13/muhradio_pcb/transmitter/cc1101/fab/drc_report.txt

** Drc report for promini_cc1101.kicad_pcb **
** Created on 2026-09-24T08:30:56 **
** Report includes: Errors, Warnings, Exclusions **

** Found 0 DRC violations **

** Found 0 unconnected pads **

** Found 0 Footprint errors **

** Ignored checks **
    - Footprint has no courtyard defined
    - Track endpoint not centered on via
    - Tuning profile track geometries
    - Footprint doesn't match symbol's footprint filters
    - Footprint component type doesn't match footprint pads

** End of Report **
