13/muhradio_pcb/receiver/cc1101/esp32s3zero/fab/preview_bottom.png

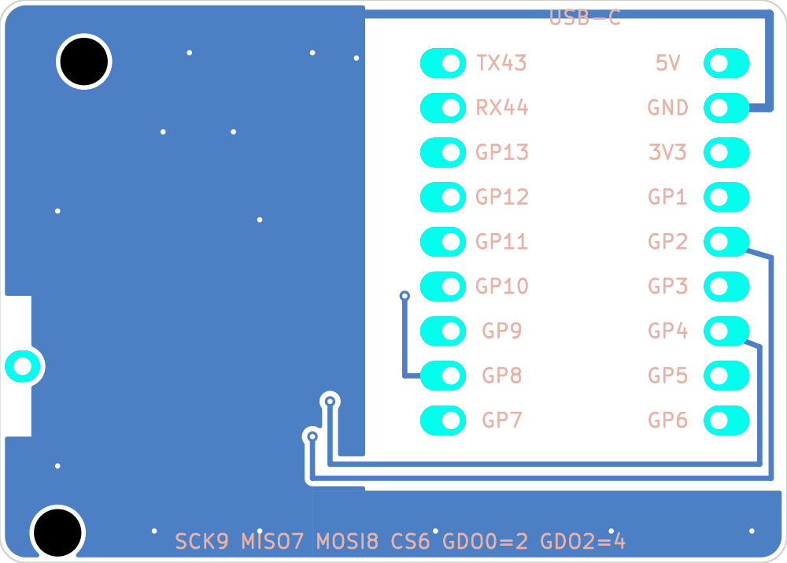
receiver/cc1101/esp32s3zero/fab/preview_bottom.png
