13/muhradio_pcb/receiver/cc1101/esp32s3zero/fab/preview_top.png

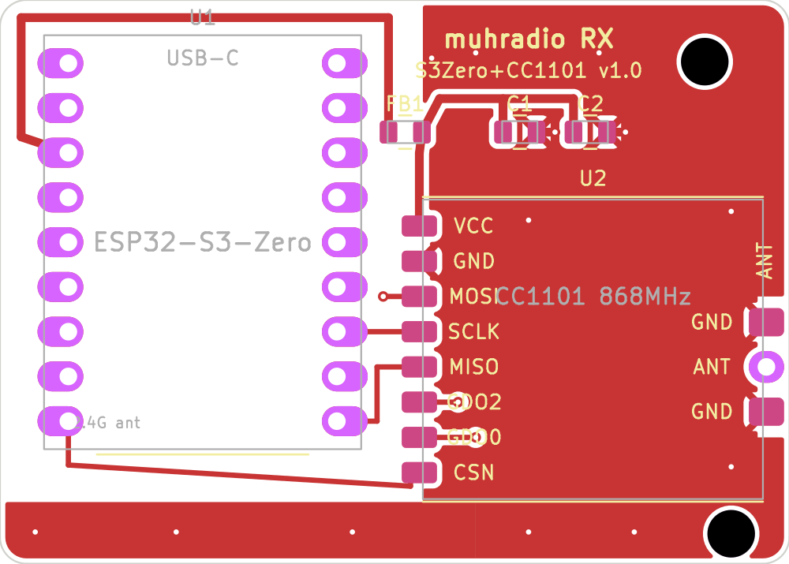
receiver/cc1101/esp32s3zero/fab/preview_top.png
