13/muhradio_pcb/receiver/cc1101/esp32s3zero/fab/render_bottom.png

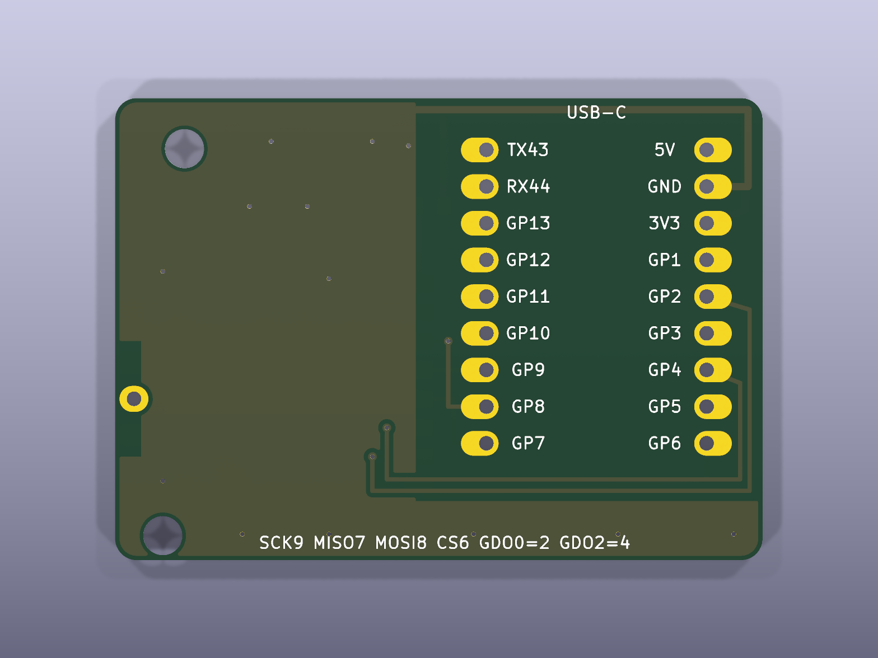
receiver/cc1101/esp32s3zero/fab/render_bottom.png
