13/muhradio_pcb/receiver/cc1101/esp32s3zero/fab/render_top.png

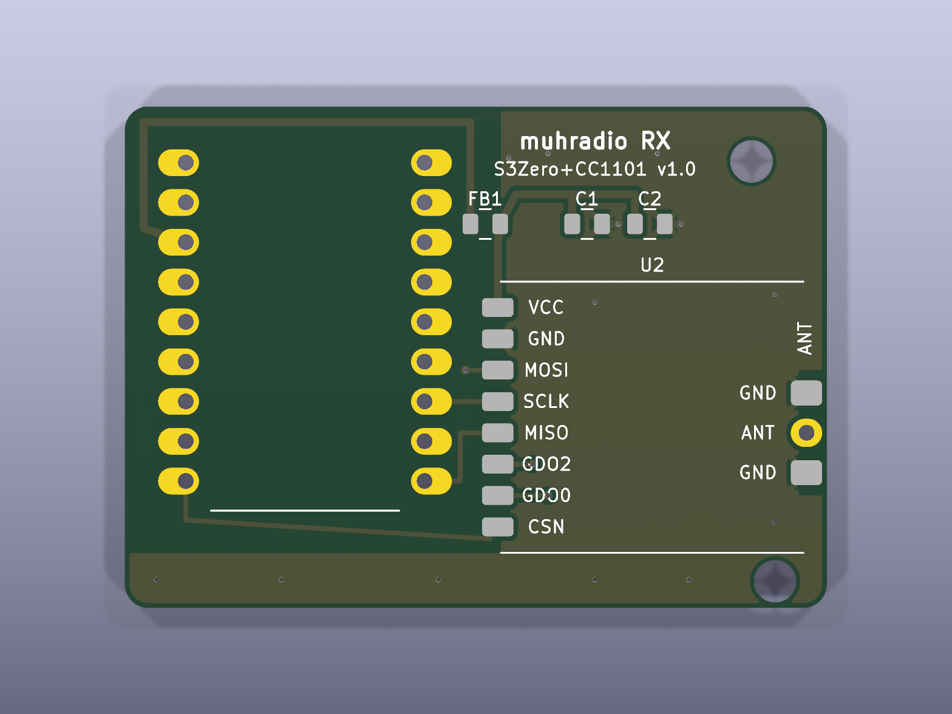
receiver/cc1101/esp32s3zero/fab/render_top.png
