13/muhradio_pcb/receiver/cc1101/esp32s3zero/fab/schematic.png

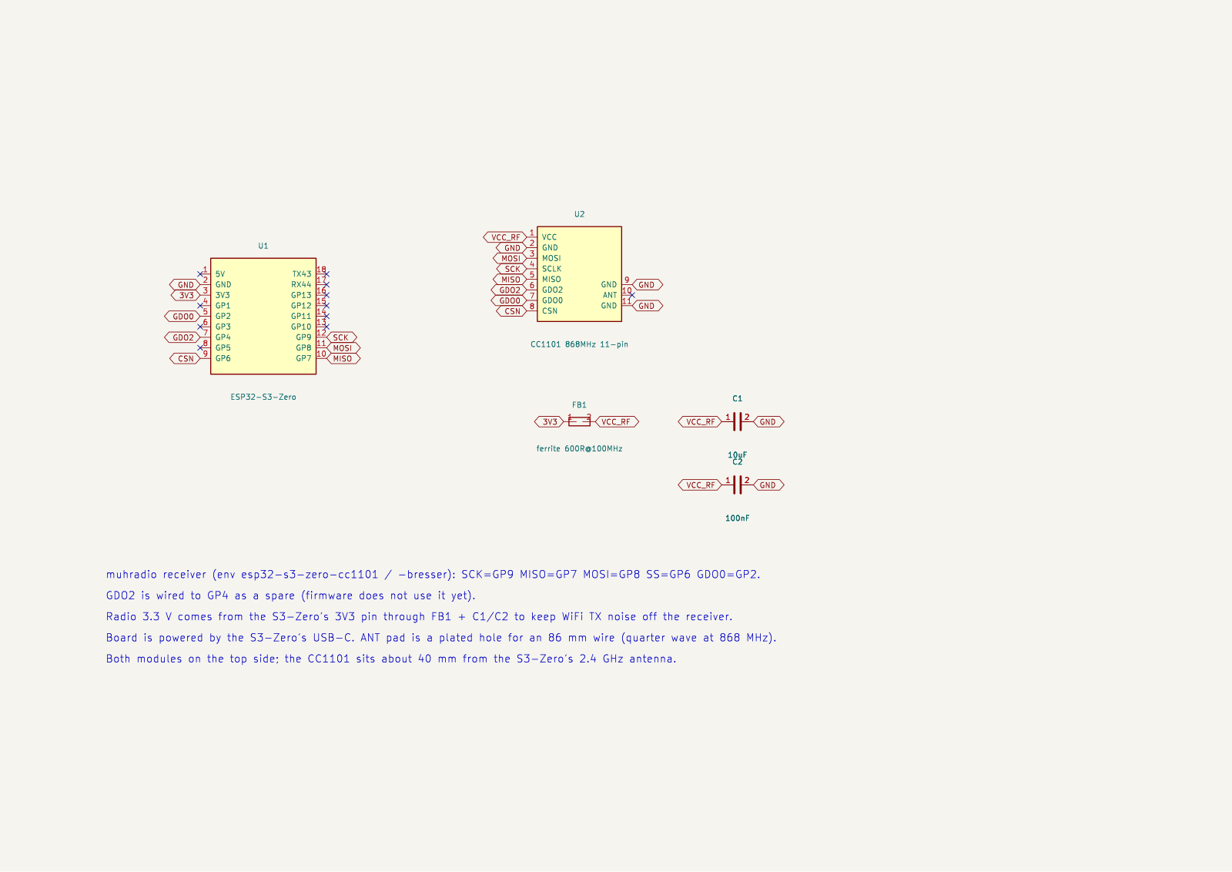
receiver/cc1101/esp32s3zero/fab/schematic.png
