13/muhradio_pcb/transmitter/cc1101/fab/preview_bottom.png

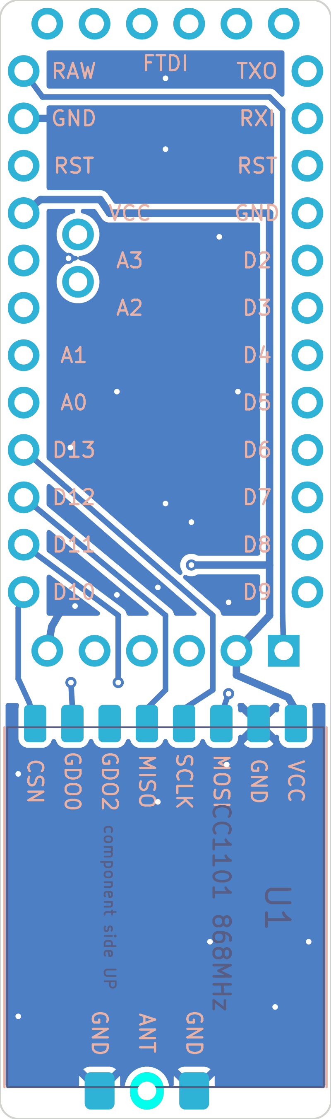
transmitter/cc1101/fab/preview_bottom.png
