13/muhradio_pcb/transmitter/cc1101/fab/preview_top.png

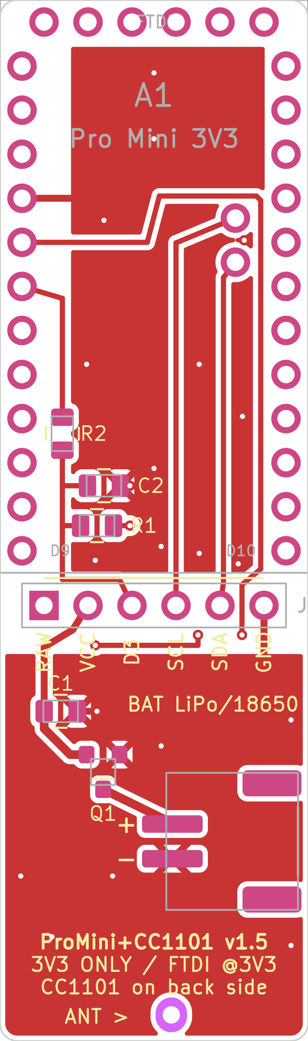
transmitter/cc1101/fab/preview_top.png
