13/muhradio_pcb/transmitter/cc1101/fab/render_bottom.png

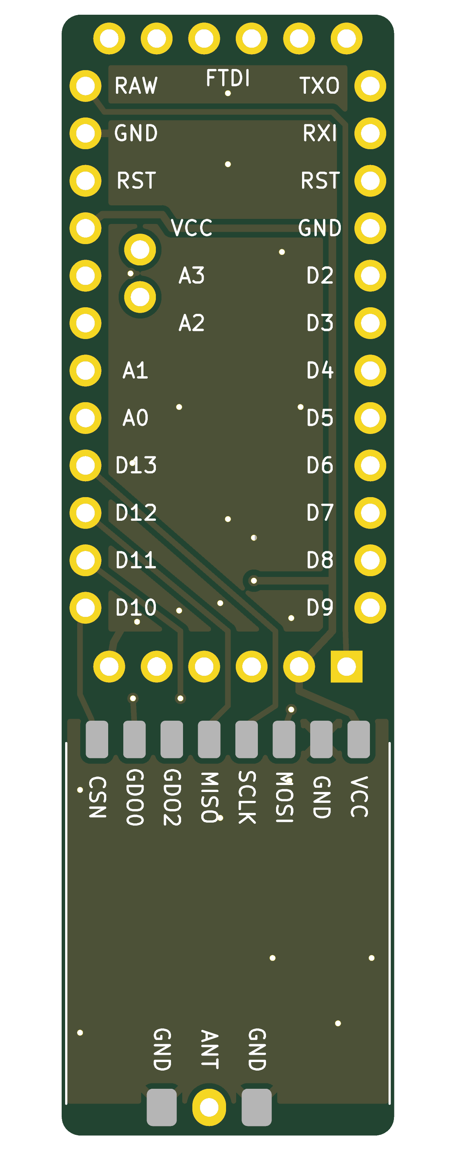
transmitter/cc1101/fab/render_bottom.png
