13/muhradio_pcb/transmitter/cc1101/fab/render_top.png

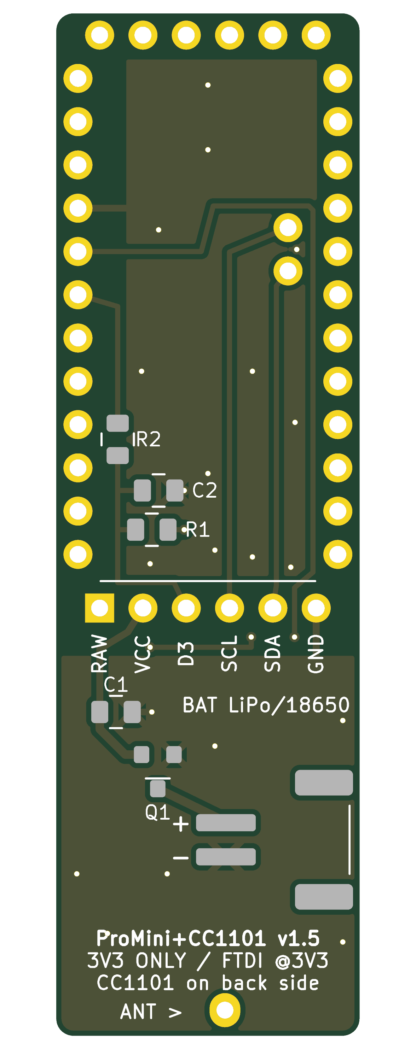
transmitter/cc1101/fab/render_top.png
