13/muhradio_pcb/transmitter/cc1101/fab/schematic.png

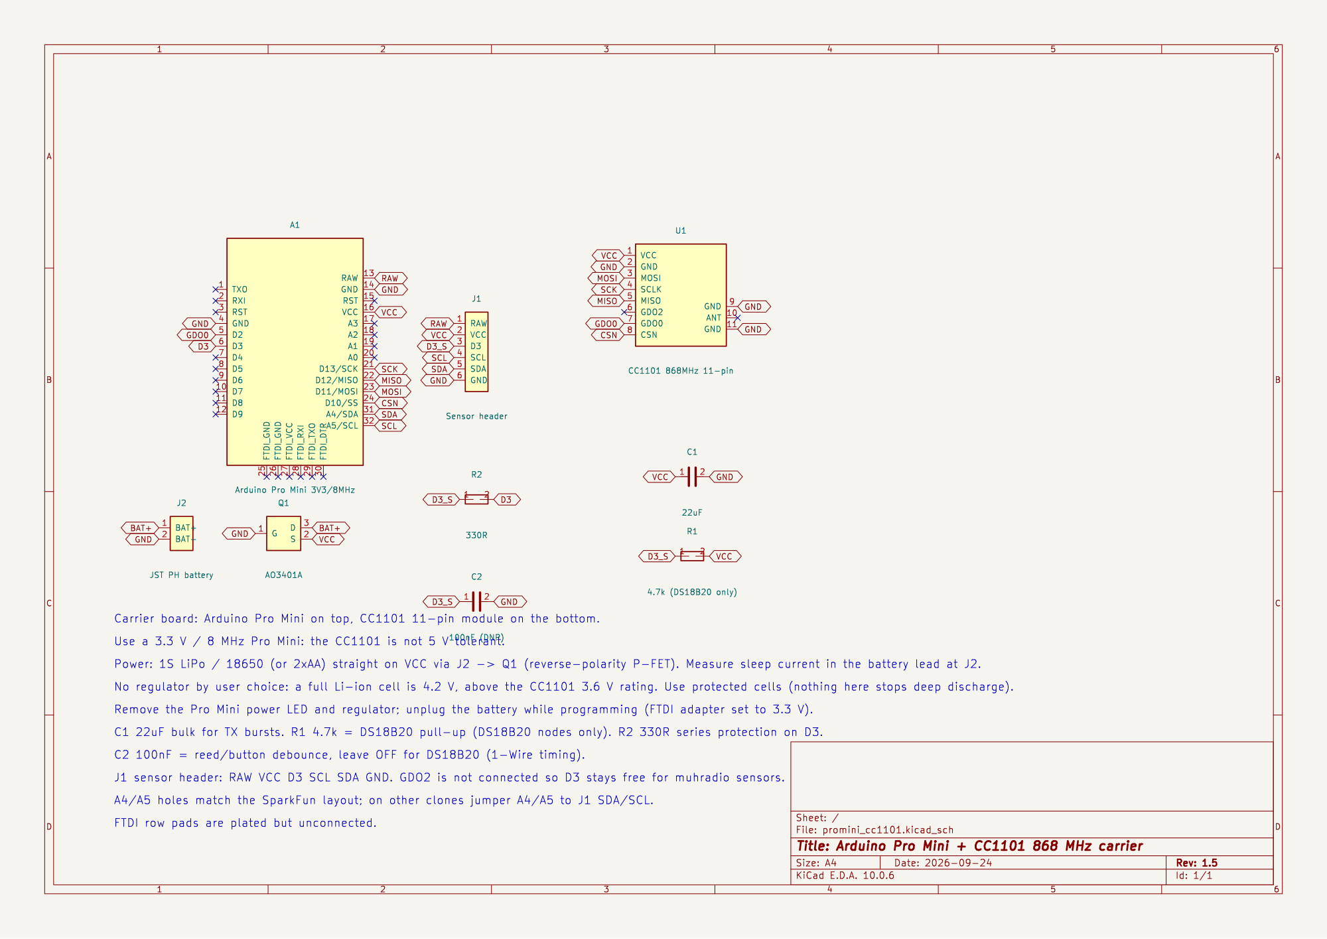
transmitter/cc1101/fab/schematic.png
