13/muhradio_pcb/transmitter/cc1101/fab/v1.4/render_top.png

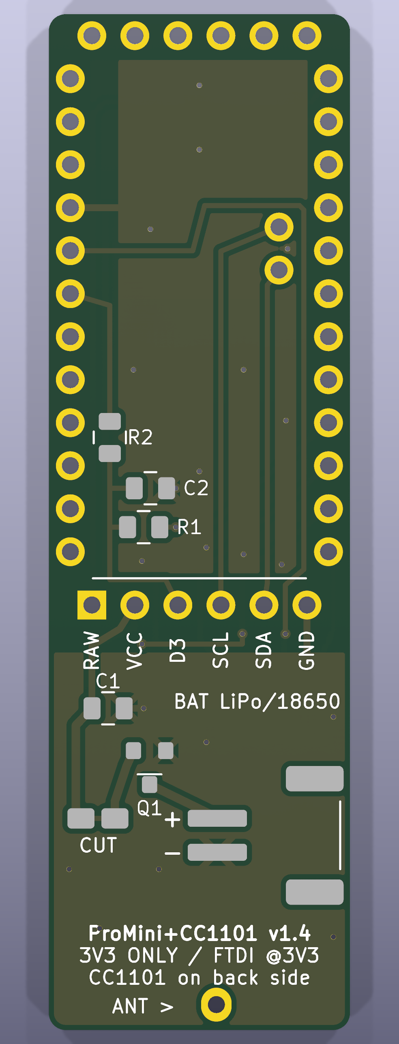
transmitter/cc1101/fab/v1.4/render_top.png
