13/muhradio_pcb/transmitter/lora/fab/preview_bottom.png

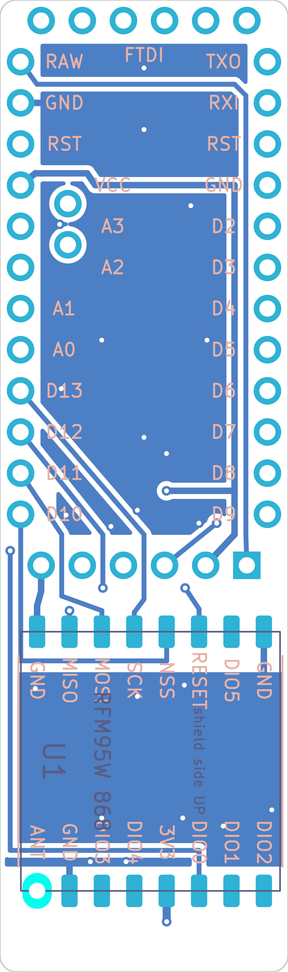
transmitter/lora/fab/preview_bottom.png
