13/muhradio_pcb/transmitter/lora/fab/preview_top.png

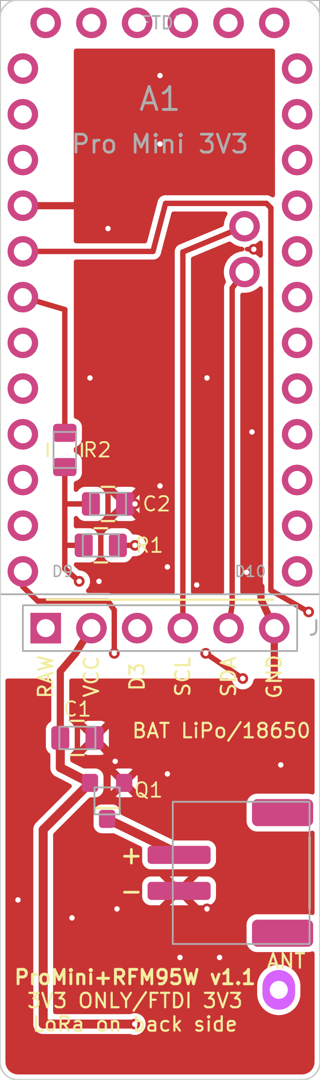
transmitter/lora/fab/preview_top.png
