13/muhradio_pcb/transmitter/lora/fab/render_bottom.png

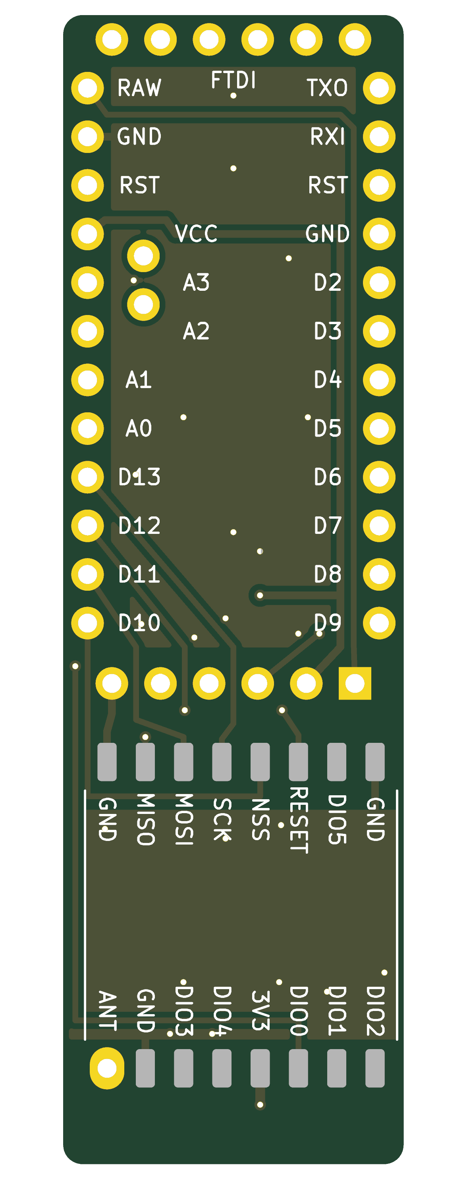
transmitter/lora/fab/render_bottom.png
