13/muhradio_pcb/transmitter/lora/fab/v1.0/render_bottom.png

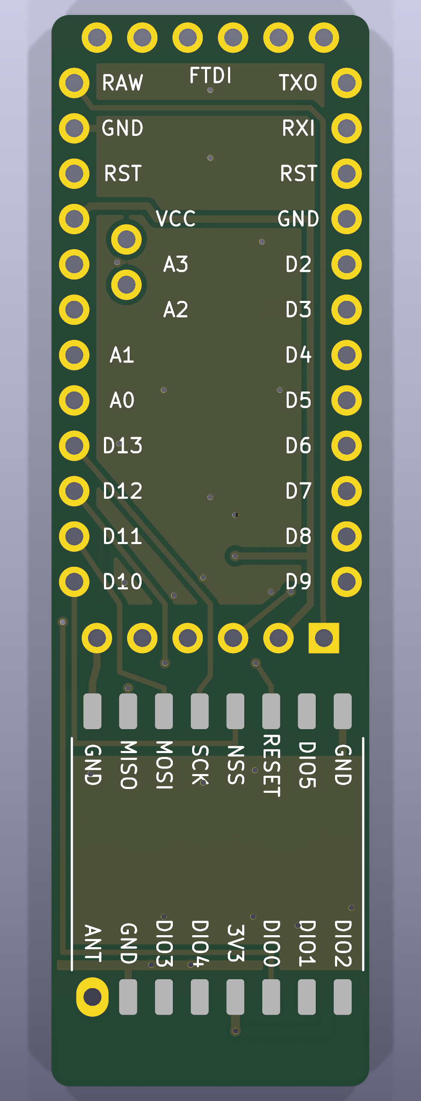
transmitter/lora/fab/v1.0/render_bottom.png
