13/muhradio_pcb/transmitter/enclosure/exports/assembly.step

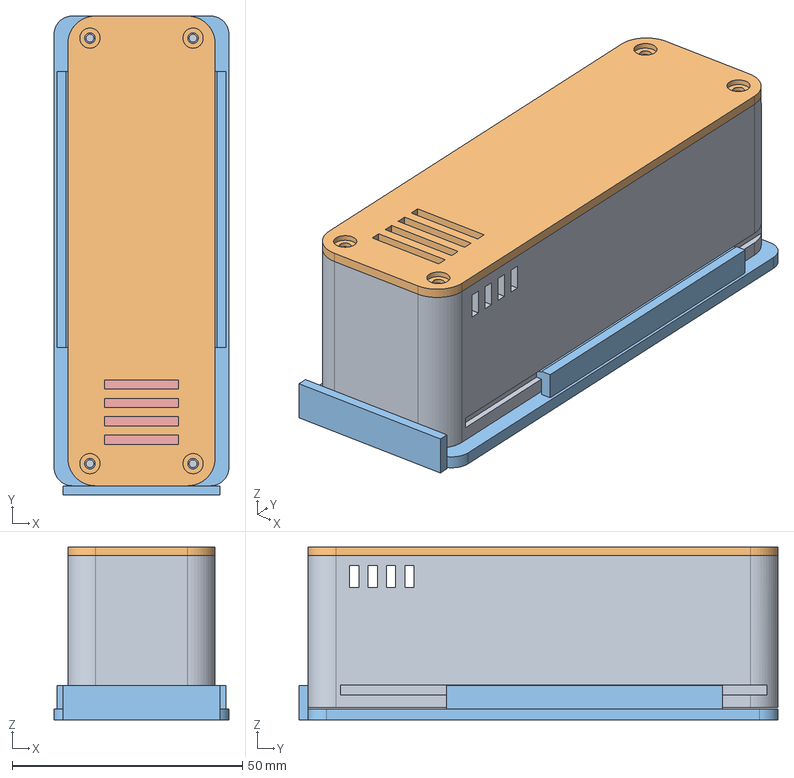
[picture p20: CAD file, 2026-10-30]
transmitter/enclosure/exports/assembly.step
38.0 x 104.0 x 37.5 mm
base
lid
wall_mount
battery_deck
sensor_shelf
