13/muhradio_pcb/transmitter/enclosure/exports/battery_deck.step

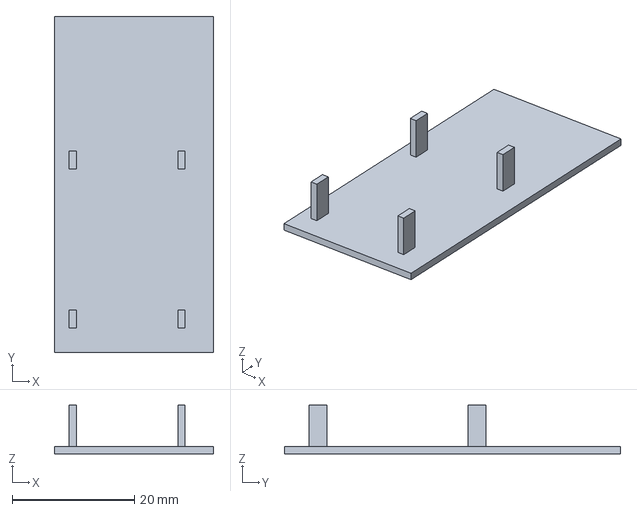
[picture p21: CAD file, 2026-10-30]
transmitter/enclosure/exports/battery_deck.step
26.0 x 55.0 x 8.00 mm
