13/muhradio_pcb/transmitter/enclosure/exports/lid.step

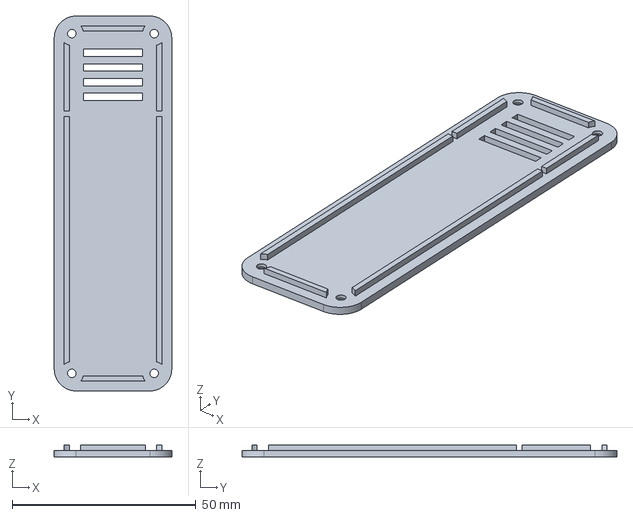
[picture p23: CAD file, 2026-10-30]
transmitter/enclosure/exports/lid.step
32.0 x 102.0 x 3.20 mm
