13/muhradio_pcb/transmitter/enclosure_magnetic/exports/lid.step

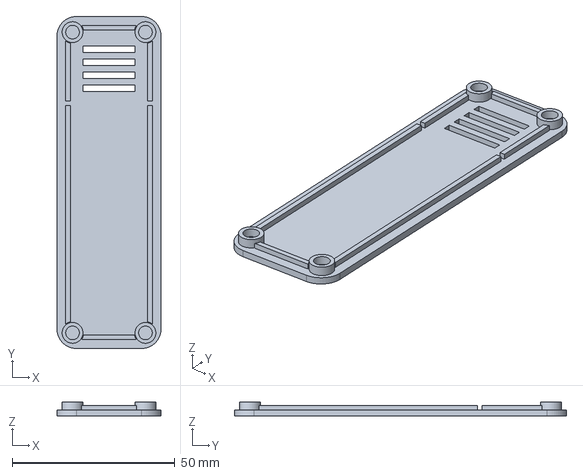
[picture p24: CAD file, 2026-10-30]
transmitter/enclosure_magnetic/exports/lid.step
32.0 x 102.0 x 4.20 mm
