13/muhradio_pcb/transmitter/enclosure_magnetic/exports/wall_mount.step

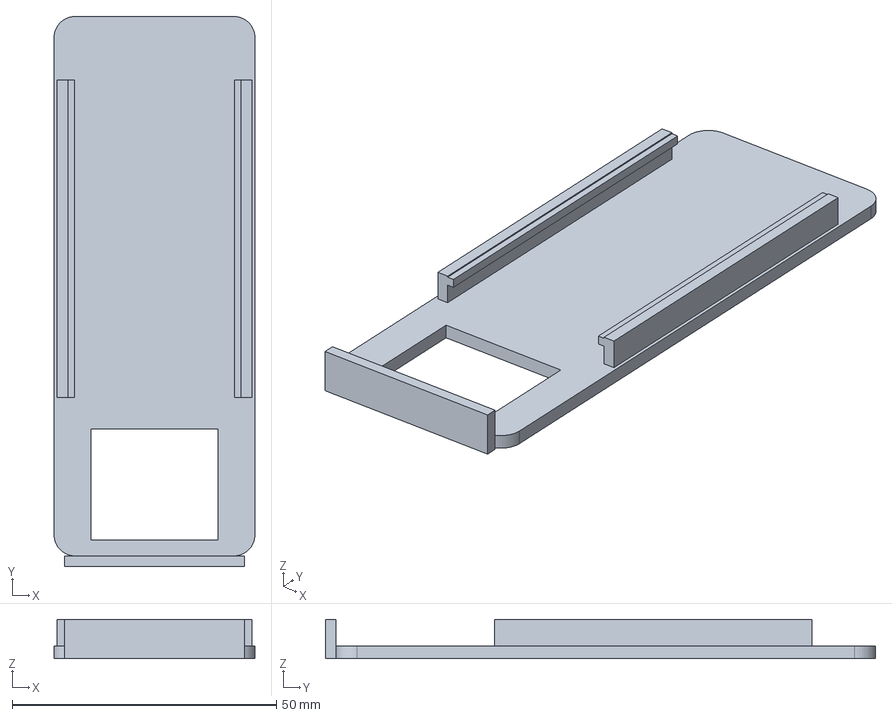
[picture p25: CAD file, 2026-10-30]
transmitter/enclosure_magnetic/exports/wall_mount.step
38.0 x 104.0 x 7.45 mm
