13/muhradio_pcb/transmitter/enclosure/exports/base.step

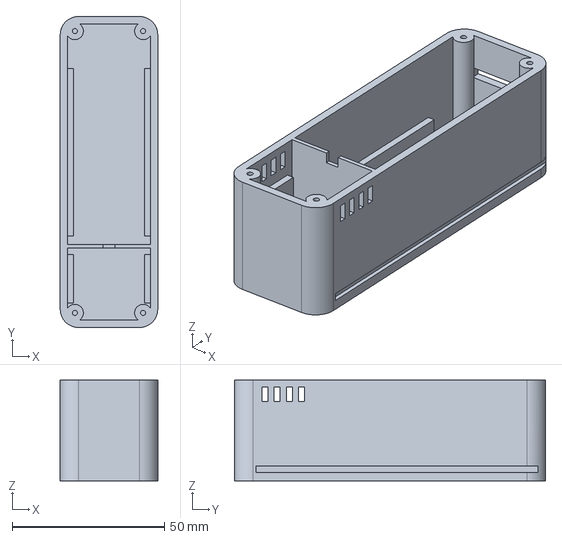
[picture p26: CAD file, 2026-10-30]
transmitter/enclosure/exports/base.step
32.0 x 102.0 x 33.0 mm
