13/muhradio_pcb/transmitter/enclosure_magnetic/exports/base.step

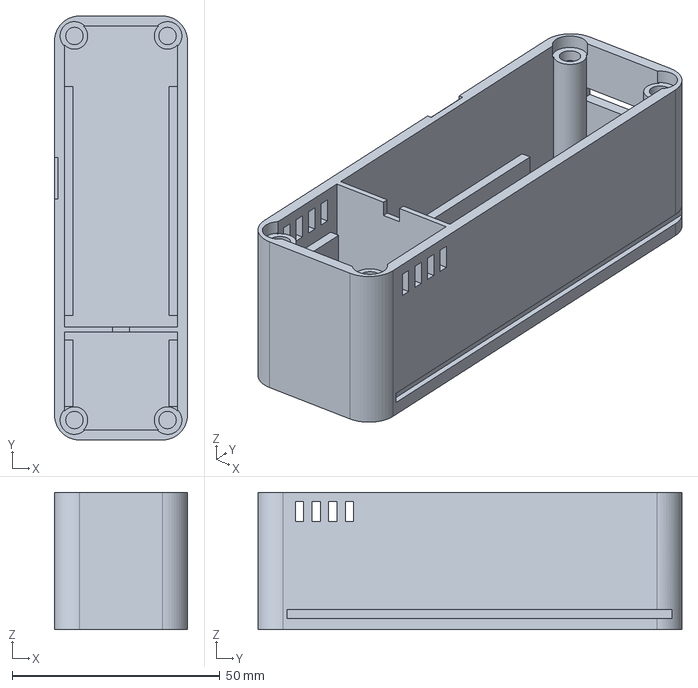
[picture p27: CAD file, 2026-10-30]
transmitter/enclosure_magnetic/exports/base.step
32.0 x 102.0 x 33.0 mm
