13/muhradio_pcb/transmitter/enclosure_screwless/exports/sensor_shelf.step

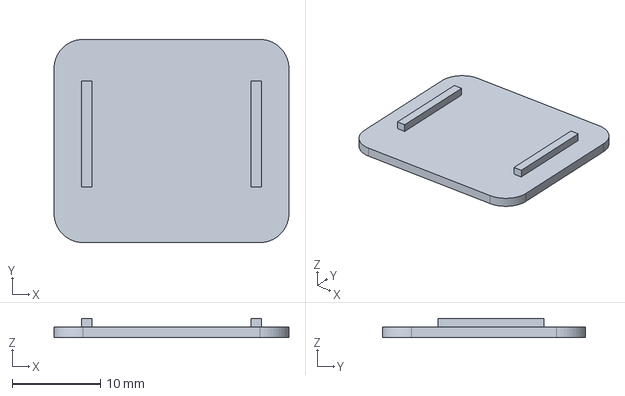
[picture p28: CAD file, 2026-10-30]
transmitter/enclosure_screwless/exports/sensor_shelf.step
26.6 x 23.0 x 2.20 mm
