13/muhradio_pcb/transmitter/enclosure_screwless/exports/lid.step

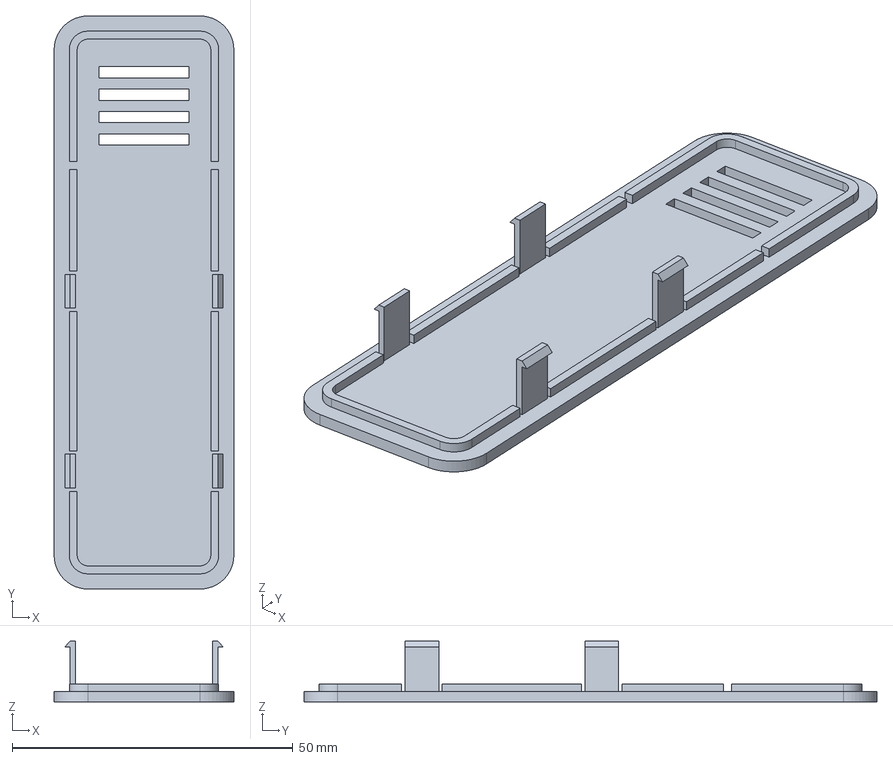
[picture p29: CAD file, 2026-10-30]
transmitter/enclosure_screwless/exports/lid.step
32.0 x 102.0 x 10.8 mm
