13/muhradio_pcb/(list of files, cad)

Other CAD files:
transmitter/enclosure_magnetic/exports/assembly.step
transmitter/enclosure/exports/sensor_shelf.step
transmitter/enclosure_magnetic/exports/battery_deck.step
transmitter/enclosure/exports/wall_mount.step
transmitter/enclosure_screwless/exports/assembly.step
transmitter/enclosure_screwless/exports/base.step
transmitter/enclosure_screwless/exports/battery_deck.step
transmitter/enclosure_screwless/exports/wall_mount.step
transmitter/enclosure/exports/base.stl
transmitter/enclosure/exports/battery_deck.stl
transmitter/enclosure/exports/lid.stl
transmitter/enclosure/exports/sensor_shelf.stl
transmitter/enclosure/exports/wall_mount.stl
transmitter/enclosure_magnetic/exports/base.stl
transmitter/enclosure_magnetic/exports/battery_deck.stl
transmitter/enclosure_magnetic/exports/lid.stl
transmitter/enclosure_magnetic/exports/sensor_shelf.stl
transmitter/enclosure_magnetic/exports/wall_mount.stl
transmitter/enclosure_screwless/exports/base.stl
transmitter/enclosure_screwless/exports/battery_deck.stl
transmitter/enclosure_screwless/exports/lid.stl
transmitter/enclosure_screwless/exports/sensor_shelf.stl
transmitter/enclosure_screwless/exports/wall_mount.stl
