13/muhradio_pcb/transmitter/cc1101/fab/schematic.pdf

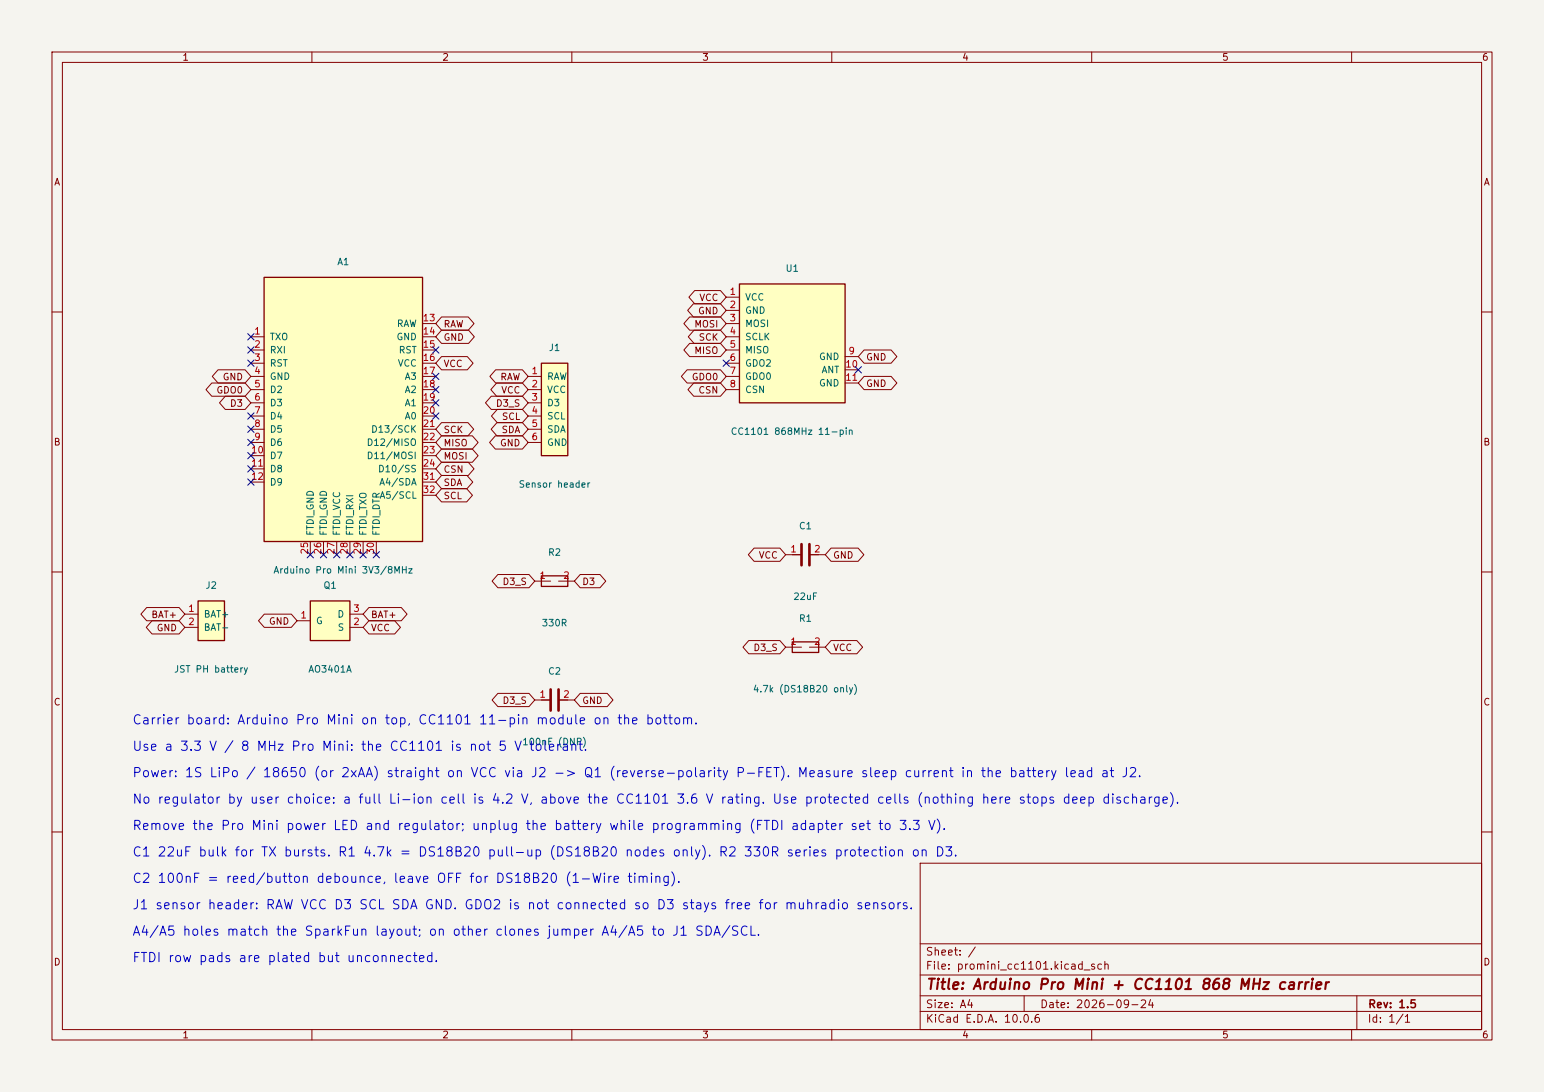
[picture p30: page 1]

GND BAT+
GND
VCC Use a 3.3 V / 8 MHz Pro Mini: the CC1101 is not 5 V tolerant.

Carrier board: Arduino Pro Mini on top, CC1101 11-pin module on the bottom.

Power: 1S LiPo / 18650 (or 2xAA) straight on VCC via J2 -> Q1 (reverse-polarity P-FET). Measure sleep current in the battery lead at J2.

No regulator by user choice: a full Li-ion cell is 4.2 V, above the CC1101 3.6 V rating. Use protected cells (nothing here stops deep discharge).

Remove the Pro Mini power LED and regulator; unplug the battery while programming (FTDI adapter set to 3.3 V).

C1 22uF bulk for TX bursts. R1 4.7k = DS18B20 pull-up (DS18B20 nodes only). R2 330R series protection on D3.

C2 100nF = reed/button debounce, leave OFF for DS18B20 (1-Wire timing).

J1 sensor header: RAW VCC D3 SCL SDA GND. GDO2 is not connected so D3 stays free for muhradio sensors. A4/A5 holes match the SparkFun layout; on other clones jumper A4/A5 to J1 SDA/SCL.

FTDI row pads are plated but unconnected.

Sheet: /
File: promini_cc1101.kicad_sch
Title: Arduino Pro Mini + CC1101 868 MHz carrier

Size: A4 | Rev: 1.5
KiCad E.D.A. 10.0.6 | Id: 1/1
