13/muhradio_pcb/transmitter/lora/fab/schematic.pdf

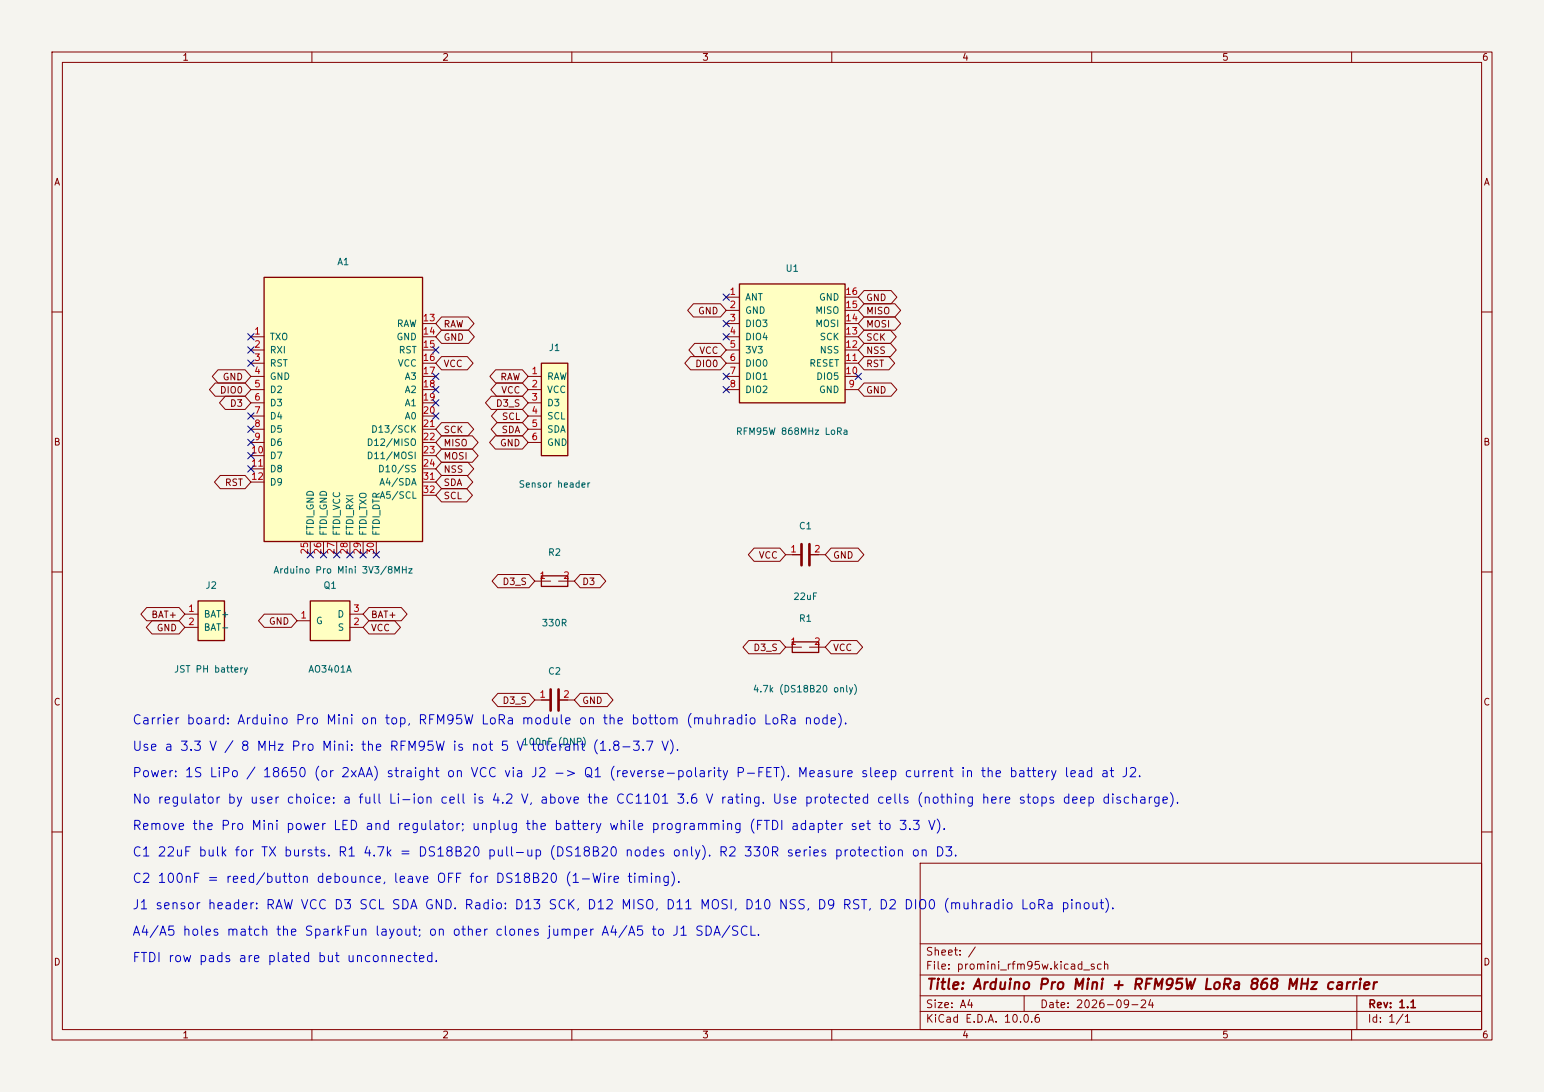
[picture p31: page 1]

VCC J1 sensor header: RAW VCC D3 SCL SDA GND. Radio: D13 SCK, D12 MISO, D11 MOSI, D10 NSS, D9 RST, D2 DIO0 (muhradio LoRa pinout).

Carrier board: Arduino Pro Mini on top, RFM95W LoRa module on the bottom (muhradio LoRa node).

Use a 3.3 V / 8 MHz Pro Mini: the RFM95W is not 5 V tolerant (1.8-3.7 V).

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

C2 100nF = reed/button debounce, leave OFF for DS18B20 (1-Wire timing).

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

FTDI row pads are plated but unconnected.

Sheet: /
File: promini_rfm95w.kicad_sch
Title: Arduino Pro Mini + RFM95W LoRa 868 MHz carrier

Size: A4 | Rev: 1.1
KiCad E.D.A. 10.0.6 | Id: 1/1
