13/muhradio_pcb/receiver/cc1101/esp32s3zero/fab/schematic.pdf

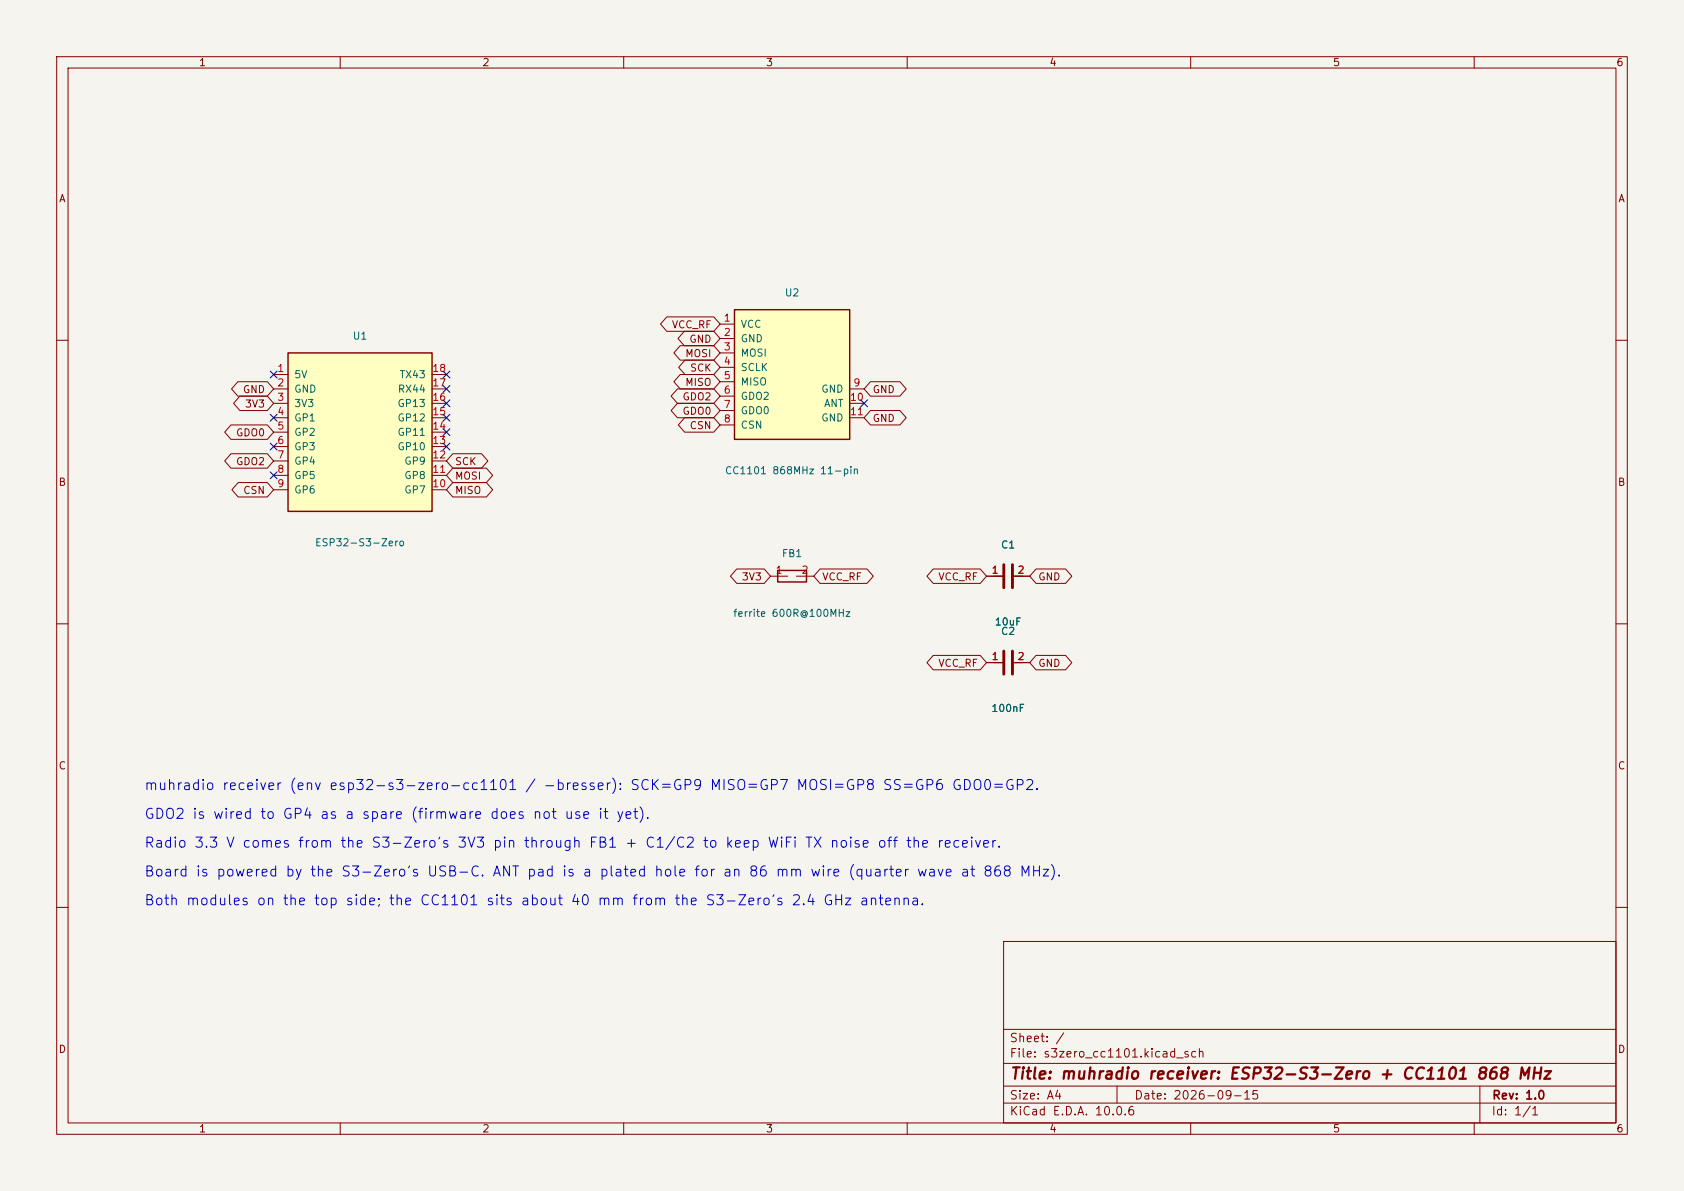
[picture p32: page 1]

muhradio receiver (env esp32-s3-zero-cc1101 / -bresser): SCK=GP9 MISO=GP7 MOSI=GP8 SS=GP6 GDO0=GP2. C2

GDO2 is wired to GP4 as a spare (firmware does not use it yet).

Radio 3.3 V comes from the S3-Zero's 3V3 pin through FB1 + C1/C2 to keep WiFi TX noise off the receiver.
Board is powered by the S3-Zero's USB-C. ANT pad is a plated hole for an 86 mm wire (quarter wave at 868 MHz).

Sheet: /
File: s3zero_cc1101.kicad_sch
Title: muhradio receiver: ESP32-S3-Zero + CC1101 868 MHz

Size: A4 | Rev: 1.0
KiCad E.D.A. 10.0.6 | Id: 1/1
