13/muhradio_pcb/transmitter/cc1101/fab/v1.4/schematic.pdf

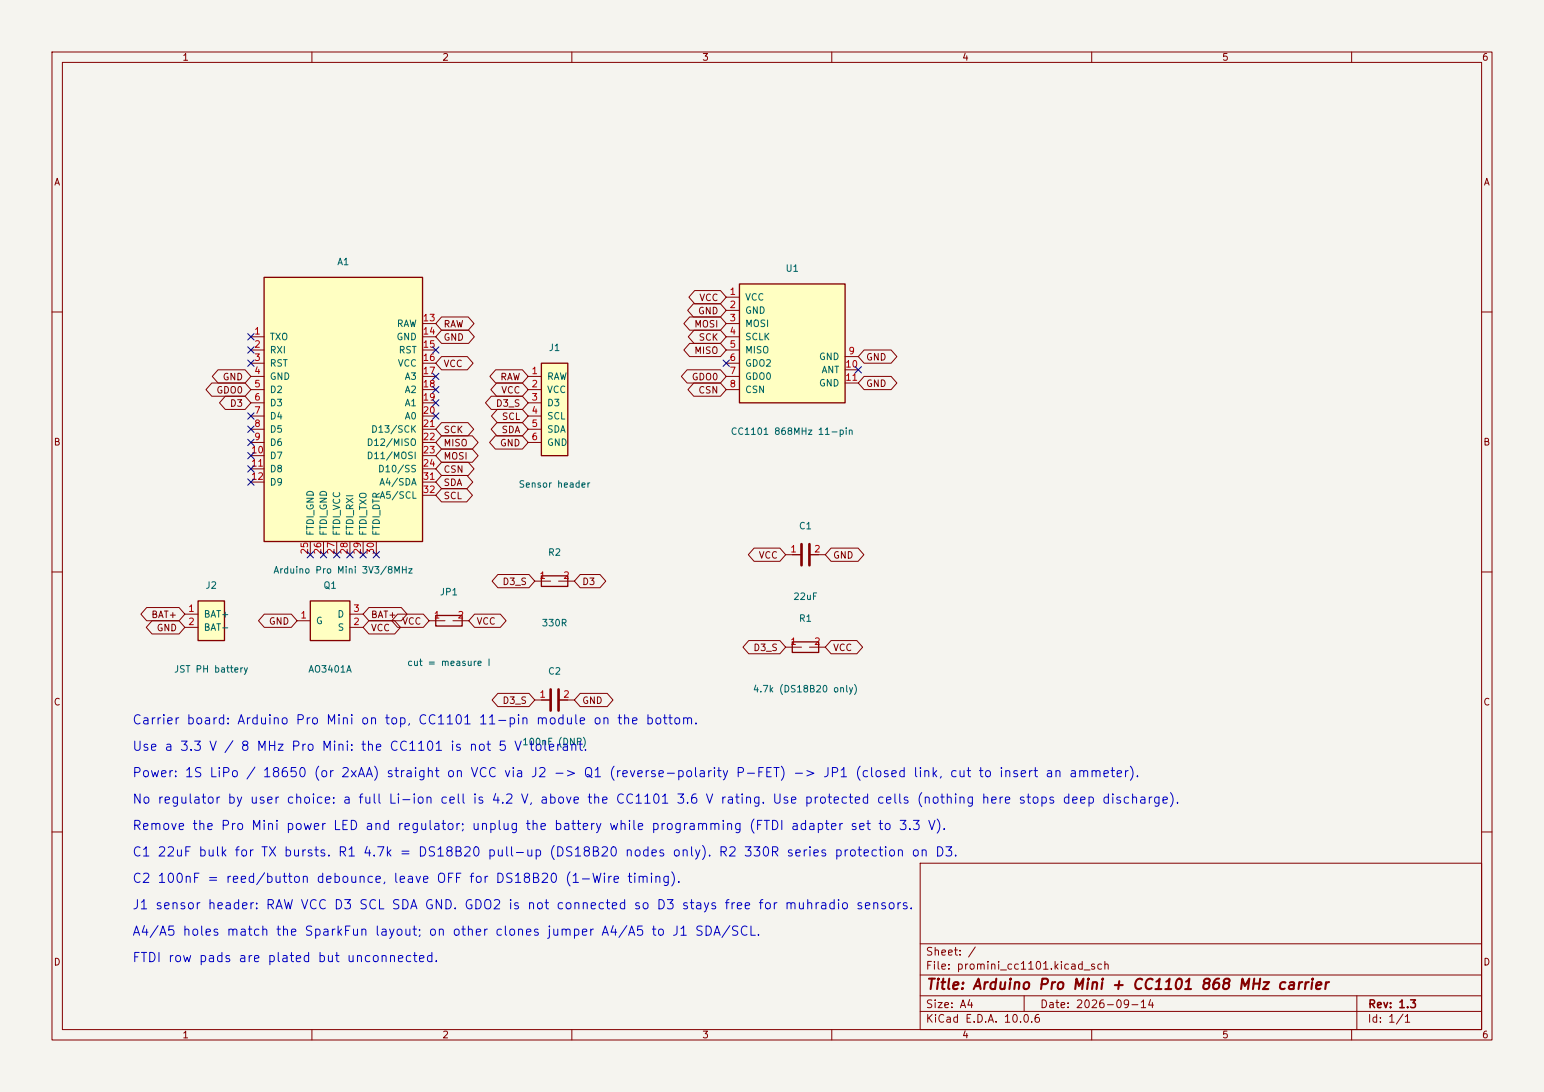
[picture p33: page 1]

CSN FTDI row pads are plated but unconnected.

Carrier board: Arduino Pro Mini on top, CC1101 11-pin module on the bottom.
Use a 3.3 V / 8 MHz Pro Mini: the CC1101 is not 5 V tolerant.
Power: 1S LiPo / 18650 (or 2xAA) straight on VCC via J2 -> Q1 (reverse-polarity P-FET) -> JP1 (closed link, cut to insert an ammeter).

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

J1 sensor header: RAW VCC D3 SCL SDA GND. GDO2 is not connected so D3 stays free for muhradio sensors. C1 22uF bulk for TX bursts. R1 4.7k = DS18B20 pull-up (DS18B20 nodes only). R2 330R series protection on D3.

C2 100nF = reed/button debounce, leave OFF for DS18B20 (1-Wire timing).

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

Sheet: /
File: promini_cc1101.kicad_sch
Title: Arduino Pro Mini + CC1101 868 MHz carrier

Size: A4 | Rev: 1.3
KiCad E.D.A. 10.0.6 | Id: 1/1
