13/muhradio_pcb/transmitter/lora/promini_rfm95w.kicad_pcb

## KiCad design transmitter/lora/promini_rfm95w.kicad_pcb (2026-09-24)

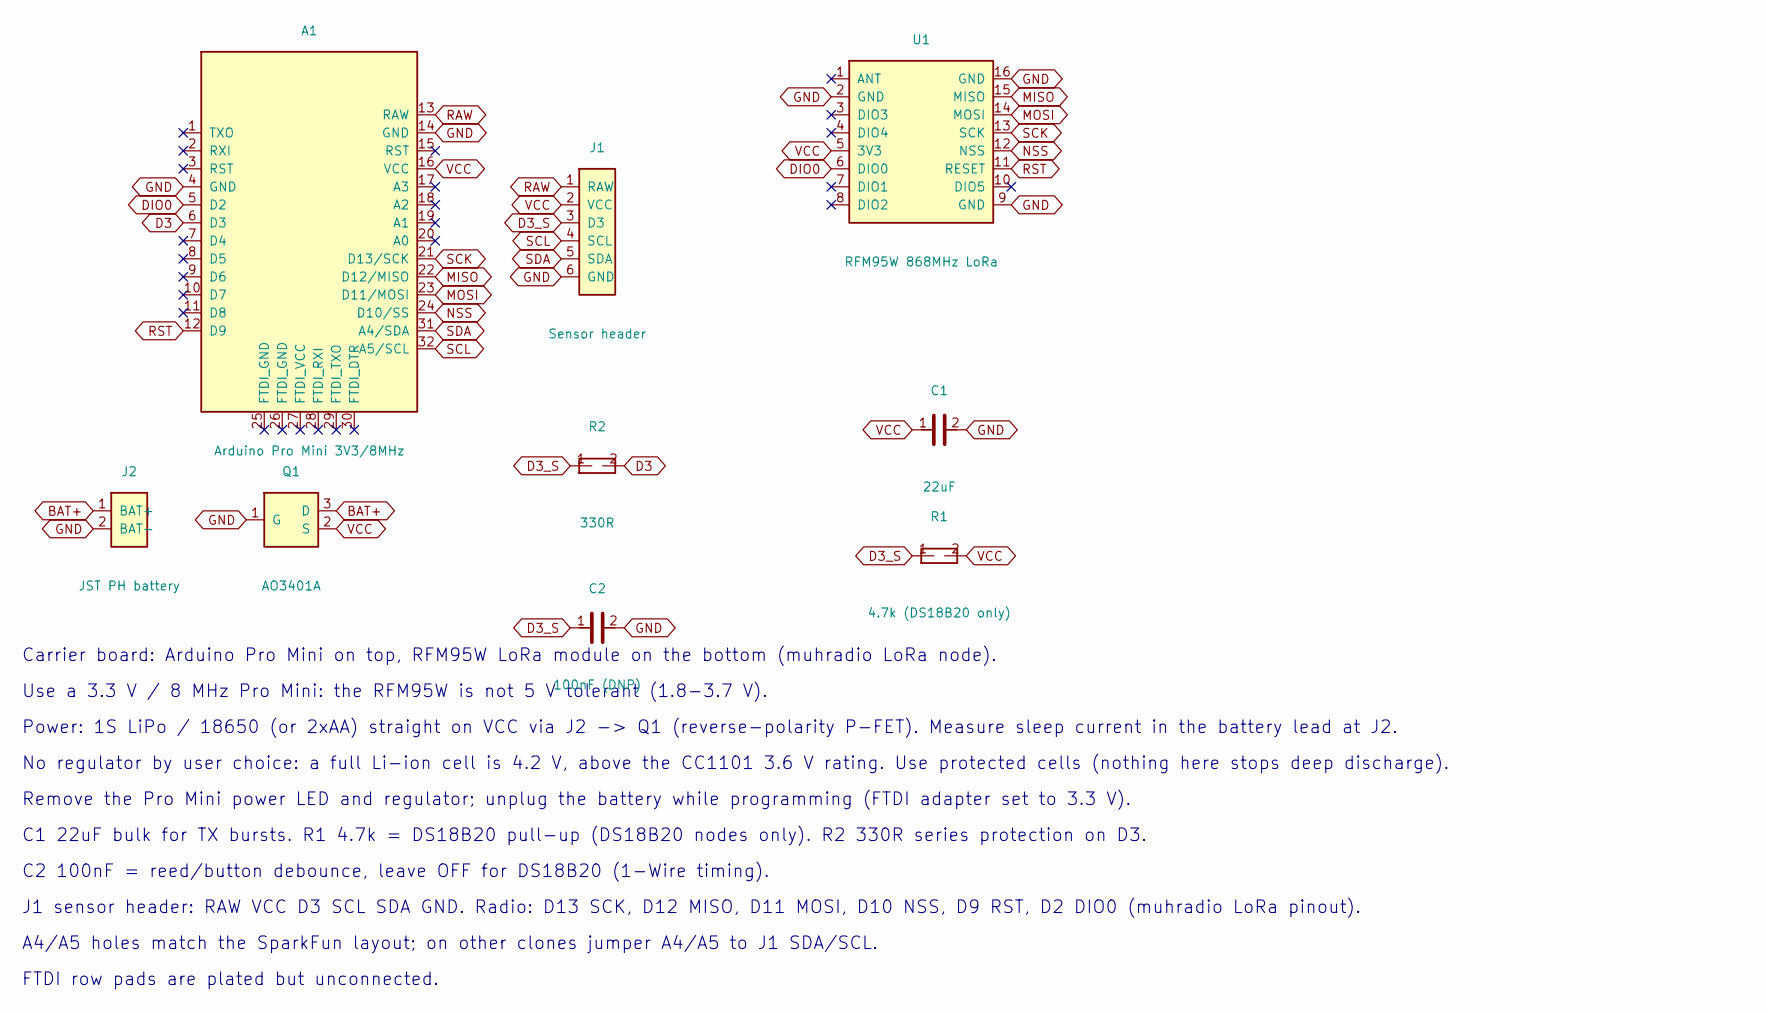
[picture p34: schematic promini_rfm95w.kicad_sch, Arduino Pro Mini + RFM95W LoRa 868 MHz carrier]

Parts:
A1: Arduino Pro Mini 3V3/8MHz; Arduino_Pro_Mini
C1: 22uF; C_0805
C2: 100nF (DNP); C_0805
J1: Sensor header; PinHeader_1x06_P2.54mm
J2: JST PH battery; JST_PH_S2B-PH-SM4-TB_SMD
Q1: AO3401A; SOT-23
R1: 4.7k (DS18B20 only); R_0805
R2: 330R; R_0805
U1: RFM95W 868MHz LoRa; HOPERF_RFM9XW_castellated

Connections:
BAT+: J2.1 (BAT+), Q1.3 (D)
D3: A1.6 (D3), R2.2
D3_S: C2.1, J1.3 (D3), R1.1, R2.1
DIO0: A1.5 (D2), U1.6 (DIO0)
GND: A1.4 (GND), A1.14 (GND), C1.2, C2.2, J1.6 (GND), J2.2 (BAT-), Q1.1 (G), U1.2 (GND), U1.9 (GND), U1.16 (GND)
MISO: A1.22 (D12/MISO), U1.15 (MISO)
MOSI: A1.23 (D11/MOSI), U1.14 (MOSI)
NSS: A1.24 (D10/SS), U1.12 (NSS)
RAW: A1.13 (RAW), J1.1 (RAW)
RST: A1.12 (D9), U1.11 (RESET)
SCK: A1.21 (D13/SCK), U1.13 (SCK)
SCL: A1.32 (A5/SCL), J1.4 (SCL)
SDA: A1.31 (A4/SDA), J1.5 (SDA)
VCC: A1.16 (VCC), C1.1, J1.2 (VCC), Q1.2 (S), R1.2, U1.5 (3V3)

Notes on the sheet:
Carrier board: Arduino Pro Mini on top, RFM95W LoRa module on the bottom (muhradio LoRa node).
Use a 3.3 V / 8 MHz Pro Mini: the RFM95W is not 5 V tolerant (1.8-3.7 V).
Power: 1S LiPo / 18650 (or 2xAA) straight on VCC via J2 -> Q1 (reverse-polarity P-FET). Measure sleep current in the battery lead at J2.
No regulator by user choice: a full Li-ion cell is 4.2 V, above the CC1101 3.6 V rating. Use protected cells (nothing here stops deep discharge).
Remove the Pro Mini power LED and regulator; unplug the battery while programming (FTDI adapter set to 3.3 V).
C1 22uF bulk for TX bursts. R1 4.7k = DS18B20 pull-up (DS18B20 nodes only). R2 330R series protection on D3.
C2 100nF = reed/button debounce, leave OFF for DS18B20 (1-Wire timing).
J1 sensor header: RAW VCC D3 SCL SDA GND. Radio: D13 SCK, D12 MISO, D11 MOSI, D10 NSS, D9 RST, D2 DIO0 (muhradio LoRa pinout).
A4/A5 holes match the SparkFun layout; on other clones jumper A4/A5 to J1 SDA/SCL.
FTDI row pads are plated but unconnected.

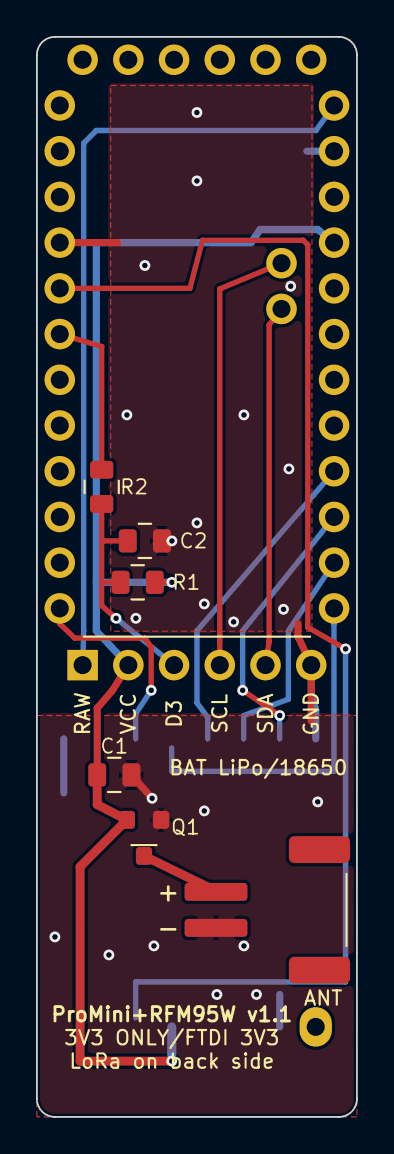
[picture p35: board promini_rfm95w.kicad_pcb from above]

Board: 2 copper layers, 17.8 x 60.0 mm, 9 parts (1 on the bottom side), 14 nets.
