13/muhradio_pcb/receiver/cc1101/esp32s3zero/s3zero_cc1101.kicad_pcb

## KiCad design receiver/cc1101/esp32s3zero/s3zero_cc1101.kicad_pcb (2026-09-24)

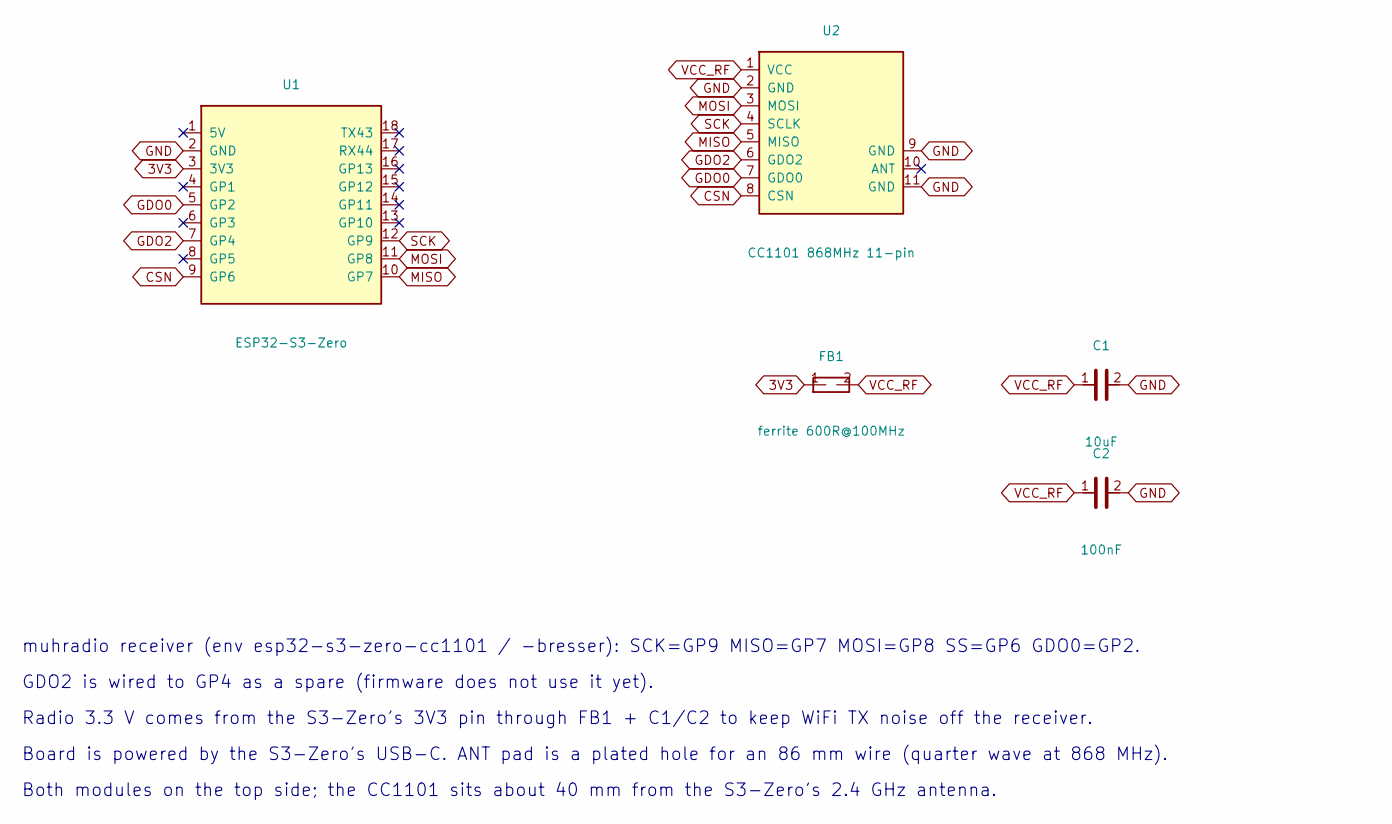
[picture p36: schematic s3zero_cc1101.kicad_sch, muhradio receiver: ESP32-S3-Zero + CC1101 868 MHz]

Parts:
C1: 10uF; C_0805
C2: 100nF; C_0805
FB1: ferrite 600R@100MHz; R_0805
U1: ESP32-S3-Zero; Waveshare_ESP32-S3-Zero
U2: CC1101 868MHz 11-pin; CC1101_11pin_castellated

Connections:
3V3: FB1.1, U1.3 (3V3)
CSN: U1.9 (GP6), U2.8 (CSN)
GDO0: U1.5 (GP2), U2.7 (GDO0)
GDO2: U1.7 (GP4), U2.6 (GDO2)
GND: C1.2, C2.2, U1.2 (GND), U2.2 (GND), U2.9 (GND), U2.11 (GND)
MISO: U1.10 (GP7), U2.5 (MISO)
MOSI: U1.11 (GP8), U2.3 (MOSI)
SCK: U1.12 (GP9), U2.4 (SCLK)
VCC_RF: C1.1, C2.1, FB1.2, U2.1 (VCC)

Notes on the sheet:
muhradio receiver (env esp32-s3-zero-cc1101 / -bresser): SCK=GP9 MISO=GP7 MOSI=GP8 SS=GP6 GDO0=GP2.
GDO2 is wired to GP4 as a spare (firmware does not use it yet).
Radio 3.3 V comes from the S3-Zero's 3V3 pin through FB1 + C1/C2 to keep WiFi TX noise off the receiver.
Board is powered by the S3-Zero's USB-C. ANT pad is a plated hole for an 86 mm wire (quarter wave at 868 MHz).
Both modules on the top side; the CC1101 sits about 40 mm from the S3-Zero's 2.4 GHz antenna.

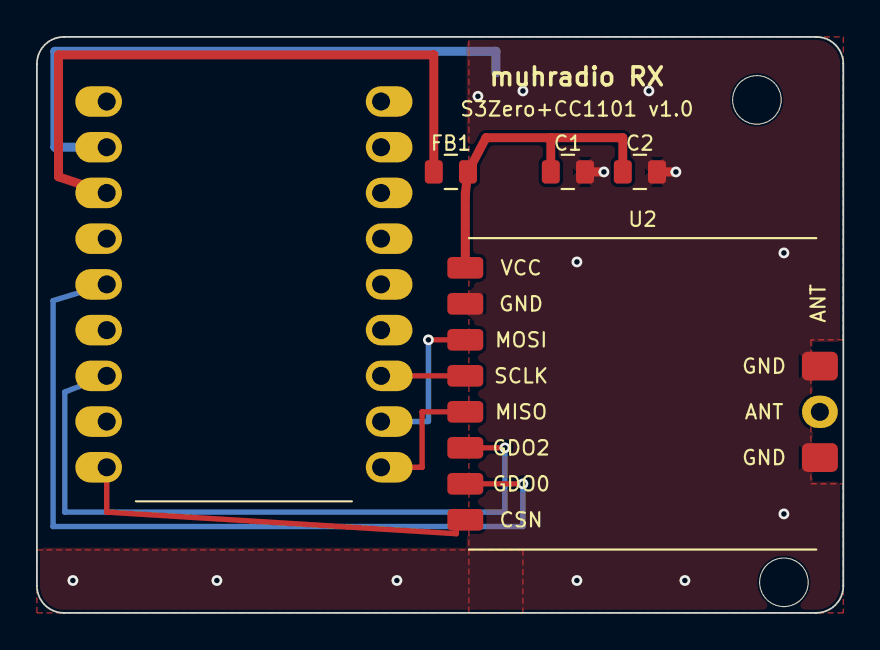
[picture p37: board s3zero_cc1101.kicad_pcb from above]

Board: 2 copper layers, 44.8 x 32.0 mm, 7 parts (0 on the bottom side), 9 nets.

Other parts of the board:
H1, H2: M2.5; MountingHole_2.7mm
