13/muhradio_pcb/(commit log)

2026-09-24 Add muhradio KiCad carrier boards
    Pro Mini + CC1101 transmitter (v1.5), Pro Mini + RFM95W LoRa transmitter
    (v1.1) and the ESP32-S3-Zero + CC1101 receiver, generated from pcbnew
    scripts with DRC/ERC reports, Gerbers, previews and BOMs.
    The transmitter carriers drop the JP1 current-measurement link: sleep
    current is measured in the battery lead at J2.
    [promini_cc1101-B_Cu.gbr, promini_cc1101-B_Fab.gbr, promini_cc1101-B_Mask.gbr, promini_cc1101-B_Paste.gbr, promini_cc1101-B_Silkscreen.gbr, promini_cc1101-Edge_Cuts.gbr, promini_cc1101-F_Cu.gbr, promini_cc1101-F_Fab.gbr]
2026-10-30 Add transmitter enclosure variants
    [assembly.step, base.step, base.stl, battery_deck.step, battery_deck.stl, lid.step, lid.stl, sensor_shelf.step]
